tdaede/cbus-joystick/cbus.kicad_pcb

## KiCad design cbus.kicad_pcb (2018-09-10)

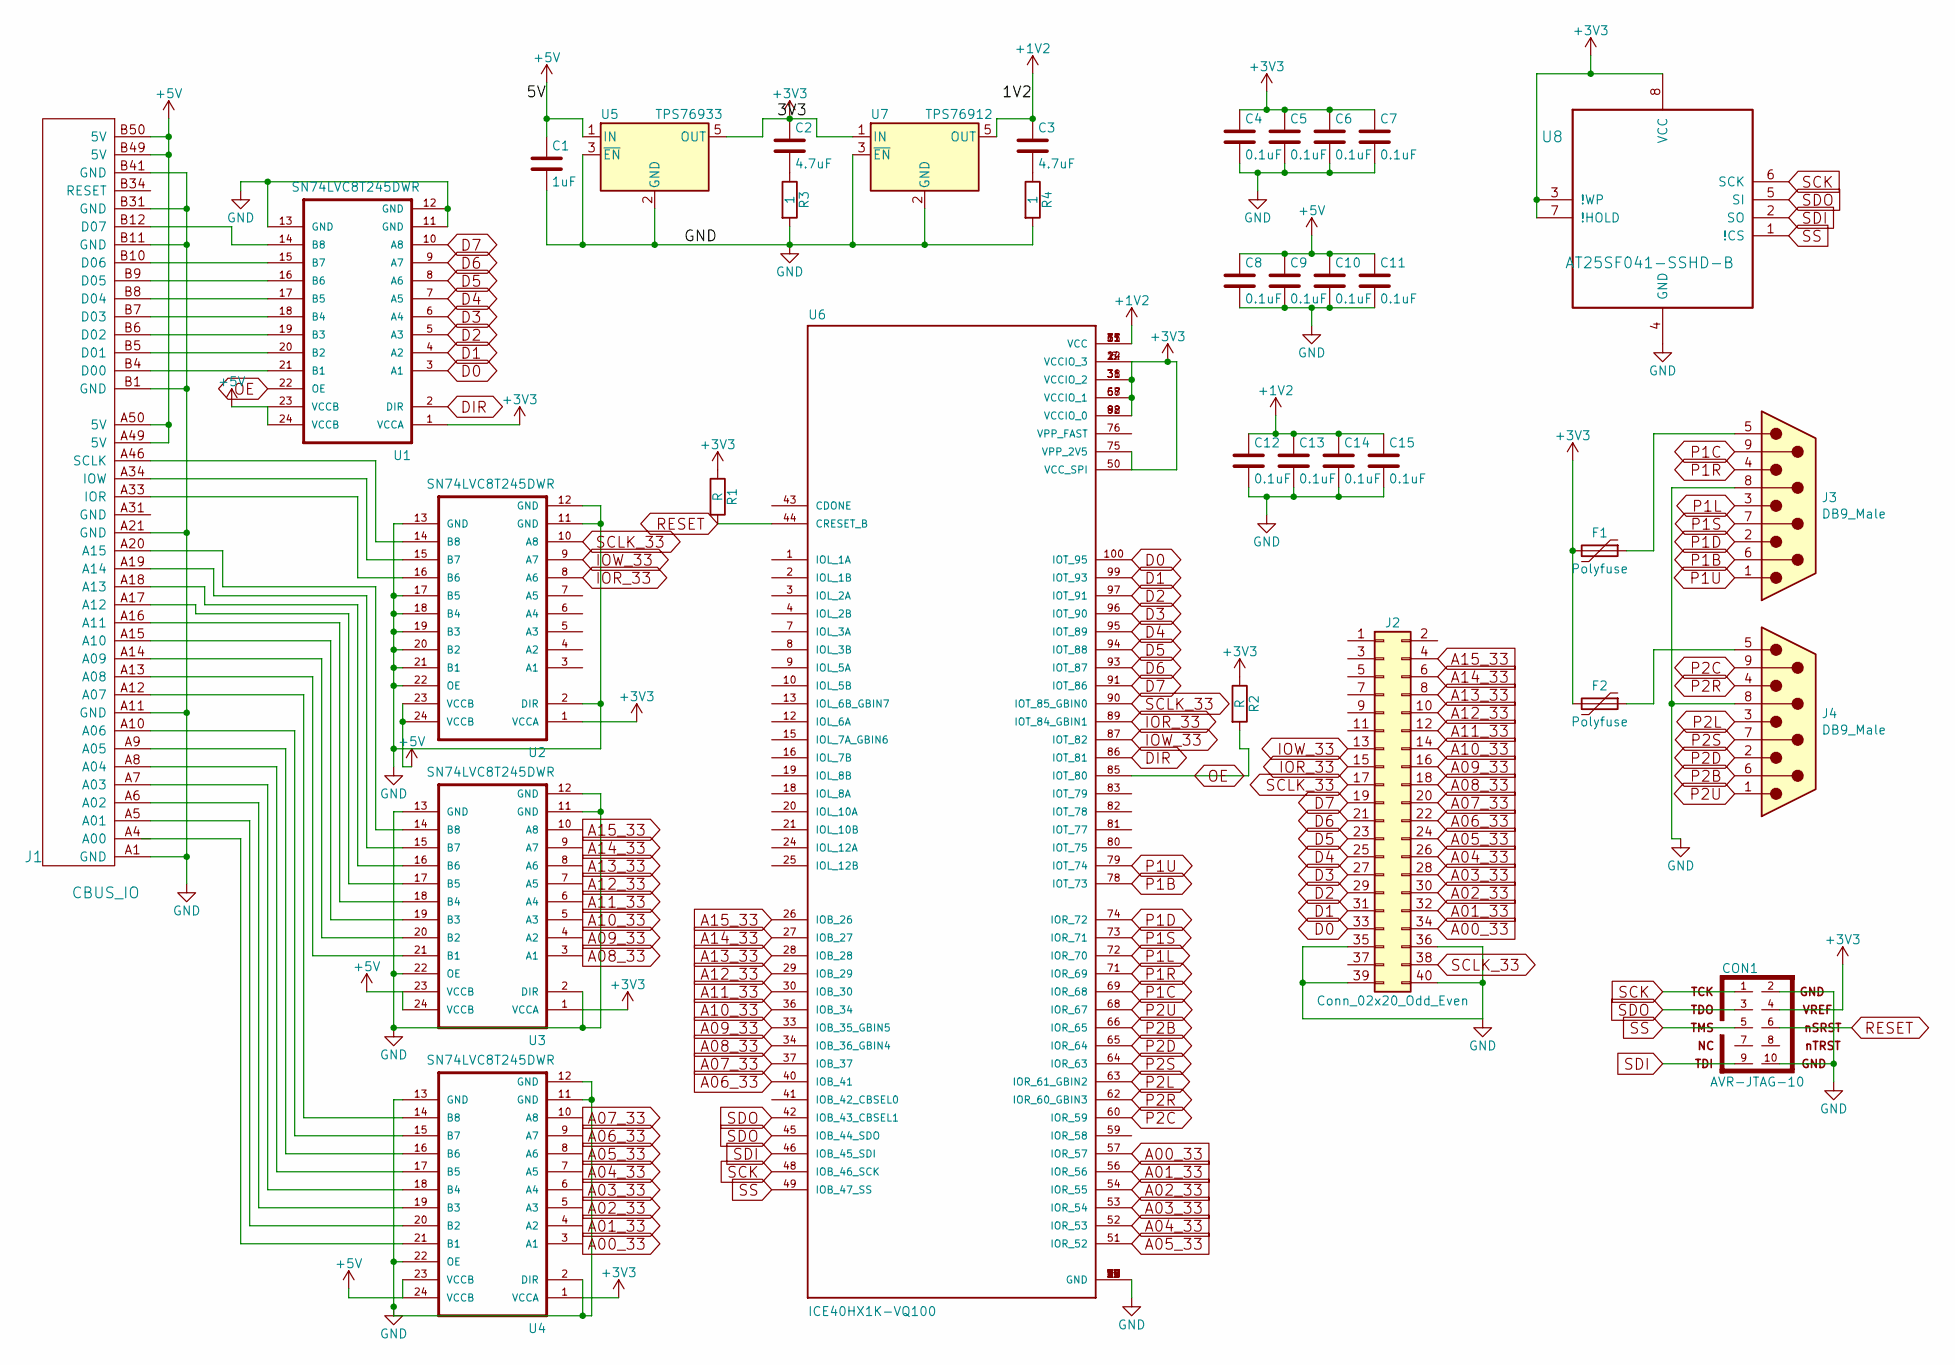
[picture p1: schematic cbus.sch]

Parts:
C1: 1uF; C_0805_HandSoldering
C2, C3: 4.7uF; C_0805_HandSoldering
C4, C5, C6, C7, C8, C9, C10, C11, C12, C13, C14, C15: 0.1uF; C_0805_HandSoldering
CON1: AVR-JTAG-10; IDC-Header_2x05_Pitch2.54mm_Straight
F1, F2: Polyfuse; R_0805_HandSoldering
J1: CBUS_IO; cbus_io
J2: Conn_02x20_Odd_Even; IDC-Header_2x20_Pitch2.54mm_Straight
J3, J4: DB9_Male; DSUB-9_Male_Horizontal_P2.77x2.84mm_EdgePinOffset4.94mm_Hou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
R1, R2: R; R_0805_HandSoldering
R3, R4: 1; R_0805_HandSoldering
U1, U2, U3, U4: SN74LVC8T245DWR; SOIC127P1030X265-24N
U5: TPS76933; SOT-23-5
U6: ICE40HX1K-VQ100; QFP50P1600X1600X120-100N
U7: TPS76912; SOT-23-5
U8: AT25SF041-SSHD-B; SOIC-8_3.9x4.9mm_Pitch1.27mm

Connections:
+1V2: C3.1, C12.1, C13.1, C14.1, C15.1, U6.11 (VCC), U6.35 (VCC), U6.61 (VCC), U6.77 (VCC), U7.5 (OUT)
+3V3: C2.1, C4.1, C5.1, C6.1, C7.1, CON1.4, F1.2, F2.2, R1.1, R2.1, U1.1 (VCCA), U2.1 (VCCA), U3.1 (VCCA), U4.1 (VCCA), U5.5 (OUT), U6.6 (VCCIO_3), U6.14 (VCCIO_3), U6.22 (VCCIO_3), U6.31 (VCCIO_2), U6.38 (VCCIO_2), U6.50 (VCC_SPI), U6.58 (VCCIO_1), U6.67 (VCCIO_1), U6.75 (VPP_2V5), U6.88 (VCCIO_0), U6.92 (VCCIO_0), U7.1 (IN), U8.3 (!WP), U8.7 (!HOLD), U8.8 (VCC)
+5V: C1.1, C8.1, C9.1, C10.1, C11.1, J1.A49 (5V), J1.A50 (5V), J1.B49 (5V), J1.B50 (5V), U1.23 (VCCB), U1.24 (VCCB), U2.23 (VCCB), U2.24 (VCCB), U3.23 (VCCB), U3.24 (VCCB), U4.23 (VCCB), U4.24 (VCCB), U5.1 (IN)
A00_33: J2.34, U4.3 (A1), U6.57 (IOR_57)
A01_33: J2.32, U4.4 (A2), U6.56 (IOR_56)
A02_33: J2.30, U4.5 (A3), U6.54 (IOR_55)
A03_33: J2.28, U4.6 (A4), U6.53 (IOR_54)
A04_33: J2.26, U4.7 (A5), U6.52 (IOR_53)
A05_33: J2.24, U4.8 (A6), U6.51 (IOR_52)
A06_33: J2.22, U4.9 (A7), U6.40 (IOB_41)
A07_33: J2.20, U4.10 (A8), U6.37 (IOB_37)
A08_33: J2.18, U3.3 (A1), U6.34 (IOB_36_GBIN4)
A09_33: J2.16, U3.4 (A2), U6.33 (IOB_35_GBIN5)
A10_33: J2.14, U3.5 (A3), U6.36 (IOB_34)
A11_33: J2.12, U3.6 (A4), U6.30 (IOB_30)
A12_33: J2.10, U3.7 (A5), U6.29 (IOB_29)
A13_33: J2.8, U3.8 (A6), U6.28 (IOB_28)
A14_33: J2.6, U3.9 (A7), U6.27 (IOB_27)
A15_33: J2.4, U3.10 (A8), U6.26 (IOB_26)
D0: J2.33, U1.3 (A1), U6.100 (IOT_95)
D1: J2.31, U1.4 (A2), U6.99 (IOT_93)
D2: J2.29, U1.5 (A3), U6.97 (IOT_91)
D3: J2.27, U1.6 (A4), U6.96 (IOT_90)
D4: J2.25, U1.7 (A5), U6.95 (IOT_89)
D5: J2.23, U1.8 (A6), U6.94 (IOT_88)
D6: J2.21, U1.9 (A7), U6.93 (IOT_87)
D7: J2.19, U1.10 (A8), U6.91 (IOT_86)
DIR: U1.2 (DIR), U6.86 (IOT_81)
GND: C1.2, C4.2, C5.2, C6.2, C7.2, C8.2, C9.2, C10.2, C11.2, C12.2, C13.2, C14.2, C15.2, CON1.2, CON1.10, J1.A1 (GND), J1.A11 (GND), J1.A21 (GND), J1.B1 (GND), J1.B11 (GND), J1.B31 (GND), J1.B41 (GND), J2.35, J2.36, J2.39, J2.40, J3.8, J4.8, R3.2, R4.2, U1.11 (GND), U1.12 (GND), U1.13 (GND), U2.2 (DIR), U2.11 (GND), U2.12 (GND), U2.13 (GND), U2.17 (B5), U2.18 (B4), U2.19 (B3), U2.20 (B2), U2.21 (B1), U2.22 (OE), U3.2 (DIR), U3.11 (GND), U3.12 (GND), U3.13 (GND), U3.22 (OE), U4.2 (DIR), U4.11 (GND), U4.12 (GND), U4.13 (GND), U4.22 (OE), U5.2 (GND), U5.3 (~EN~), U6.5 (GND), U6.17 (GND), U6.23 (GND), U6.32 (GND), U6.39 (GND), U6.47 (GND), U6.55 (GND), U6.70 (GND), U6.84 (GND), U6.98 (GND), U7.2 (GND), U7.3 (~EN~), U8.4 (GND)
IOR_33: J2.15, U2.8 (A6), U6.89 (IOT_84_GBIN1)
IOW_33: J2.13, U2.9 (A7), U6.87 (IOT_82)
unnamed: C2.2, R3.1
unnamed: C3.2, R4.1
unnamed: F1.1, J3.5
unnamed: F2.1, J4.5
unnamed: J1.A5 (A01), U4.20 (B2)
unnamed: J1.A6 (A02), U4.19 (B3)
unnamed: J1.A7 (A03), U4.18 (B4)
unnamed: J1.A8 (A04), U4.17 (B5)
unnamed: J1.A9 (A05), U4.16 (B6)
unnamed: J1.A10 (A06), U4.15 (B7)
unnamed: J1.A12 (A07), U4.14 (B8)
unnamed: J1.A13 (A08), U3.21 (B1)
unnamed: J1.A14 (A09), U3.20 (B2)
unnamed: J1.A15 (A10), U3.19 (B3)
unnamed: J1.A16 (A11), U3.18 (B4)
unnamed: J1.A17 (A12), U3.17 (B5)
unnamed: J1.A18 (A13), U3.16 (B6)
unnamed: J1.A19 (A14), U3.15 (B7)
unnamed: J1.A20 (A15), U3.14 (B8)
unnamed: J1.A33 (IOR), U2.16 (B6)
unnamed: J1.A34 (IOW), U2.15 (B7)
unnamed: J1.A46 (SCLK), U2.14 (B8)
unnamed: J1.B4 (D00), U1.21 (B1)
unnamed: J1.B5 (D01), U1.20 (B2)
unnamed: J1.B6 (D02), U1.19 (B3)
unnamed: J1.B7 (D03), U1.18 (B4)
unnamed: J1.B8 (D04), U1.17 (B5)
unnamed: J1.B9 (D05), U1.16 (B6)
unnamed: J1.B10 (D06), U1.15 (B7)
unnamed: J1.B12 (D07), U1.14 (B8)
OE: R2.2, U1.22 (OE), U6.85 (IOT_80)
P1B: J3.6, U6.78 (IOT_73)
P1C: J3.9, U6.69 (IOR_68)
P1D: J3.2, U6.74 (IOR_72)
P1L: J3.3, U6.72 (IOR_70)
P1R: J3.4, U6.71 (IOR_69)
P1S: J3.7, U6.73 (IOR_71)
P1U: J3.1, U6.79 (IOT_74)
P2B: J4.6, U6.66 (IOR_65)
P2C: J4.9, U6.60 (IOR_59)
P2D: J4.2, U6.65 (IOR_64)
P2L: J4.3, U6.63 (IOR_61_GBIN2)
P2R: J4.4, U6.62 (IOR_60_GBIN3)
P2S: J4.7, U6.64 (IOR_63)
P2U: J4.1, U6.68 (IOR_67)
RESET: CON1.6, R1.2, U6.44 (CRESET_B)
SCK: CON1.1, U6.48 (IOB_46_SCK), U8.6 (SCK)
SCLK_33: J2.17, J2.38, U2.10 (A8), U6.90 (IOT_85_GBIN0)
SDI: CON1.9, U6.46 (IOB_45_SDI), U8.2 (SO)
SDO: CON1.3, U6.42 (IOB_43_CBSEL1), U6.45 (IOB_44_SDO), U8.5 (SI)
SS: CON1.5, U6.49 (IOB_47_SS), U8.1 (!CS)

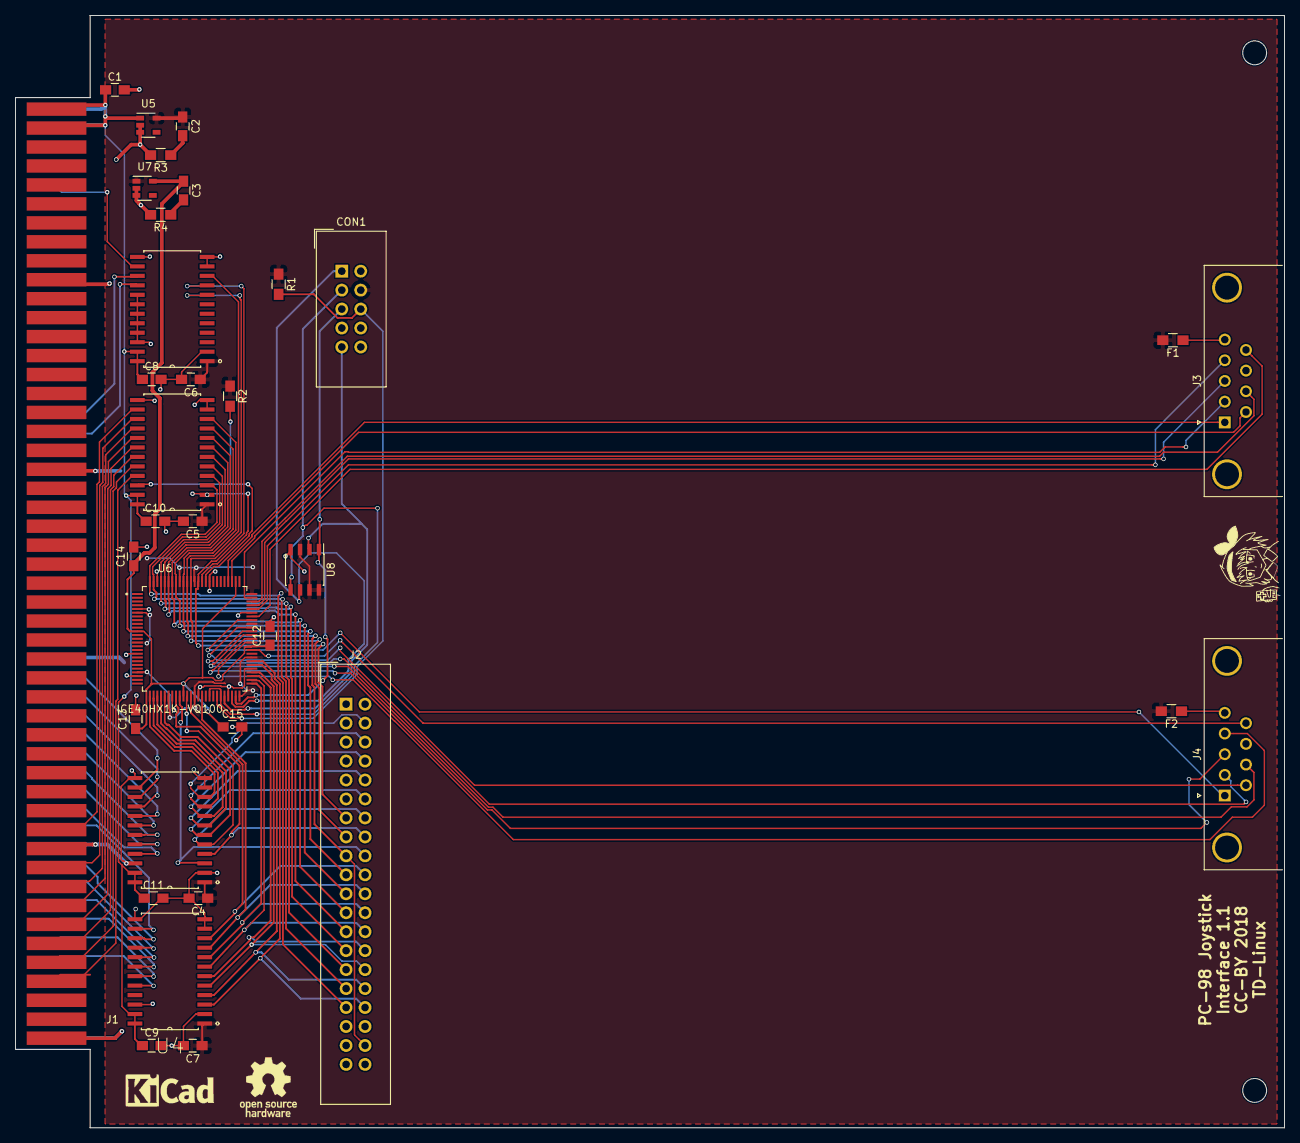
[picture p2: board cbus.kicad_pcb from above]

Board: 2 copper layers, 170.0 x 149.0 mm, 35 parts (0 on the bottom side), 82 nets.

Other parts of the board:
svg2mod: G***; alice2
