tdaede/cbus-joystick/(commit log)

2018-08-19 Finish routing
    [cbus.kicad_pcb, cbus.sch]
2018-09-04 Fix connector spacing
    [cbus.kicad_pcb]
2018-09-05 set PCB page size to letter
    [cbus.kicad_pcb]
2018-09-07 Routing for v1.1
    [cbus.kicad_pcb]
2018-09-10 Add 3D models
    [cbus.kicad_pcb]
2018-09-14 make LED blink
