tdaede/cbus-joystick/(notices)

Notices in the files:
cbus.kicad_pcb:
CC-BY 2018
